ulyssecrn/usb-pd-card/jlcpcb/production_files/BOM-usb-pd-card.csv

Comment | Designator | Footprint | LCSC | Quantity
100k | R4 | R_0402_1005Metric | C25741 | 1
100nF | C5 | C_0402_1005Metric | C1525 | 1
10k | R6 | R_0402_1005Metric | C25744 | 1
10uF | C4 | C_0603_1608Metric | C19702 | 1
10uF | C2 | C_0603_1608Metric | C96446 | 1
15k | R5 | R_0402_1005Metric | C25756 | 1
1k | R10,R11,R12,R13,R14,R15,R16,R17,R18,R7,R8,R9 | R_0402_1005Metric | C11702 | 12
220nF | C1 | C_0402_1005Metric | C16772 | 1
47 | R1 | R_0402_1005Metric | C25118 | 1
5.1k | R2,R3 | R_0402_1005Metric | C25905 | 2
CH32X035G8U6 | U1 | WQFN-28-1EP_4x4mm_P0.4mm_EP2.7x2.7mm | C7437027 | 1
H7VL10B | D3,D4 | D_0402_1005Metric | C20615787 | 2
LED | D10,D11,D12,D13,D14,D15,D16,D2,D5,D6,D7,D8,D9 | LED_0603_1608Metric | C2286 | 13
ME6228A33M3G | U2 | SOT-23-3_L2.9-W1.6-P1.90-LS2.8-BR | C487914 | 1
NT3H2111W0FHKH | U3 | XQFN-8_L1.6-W1.6-P0.50-BL_NT3H2111W0FHKH | C710403 | 1
SMF20A | D1 | D_SOD-123F | C41411782 | 1
