ulyssecrn/usb-pd-card/usb-pd-card.kicad_pcb

## KiCad design usb-pd-card.kicad_pcb (2026-10-11)

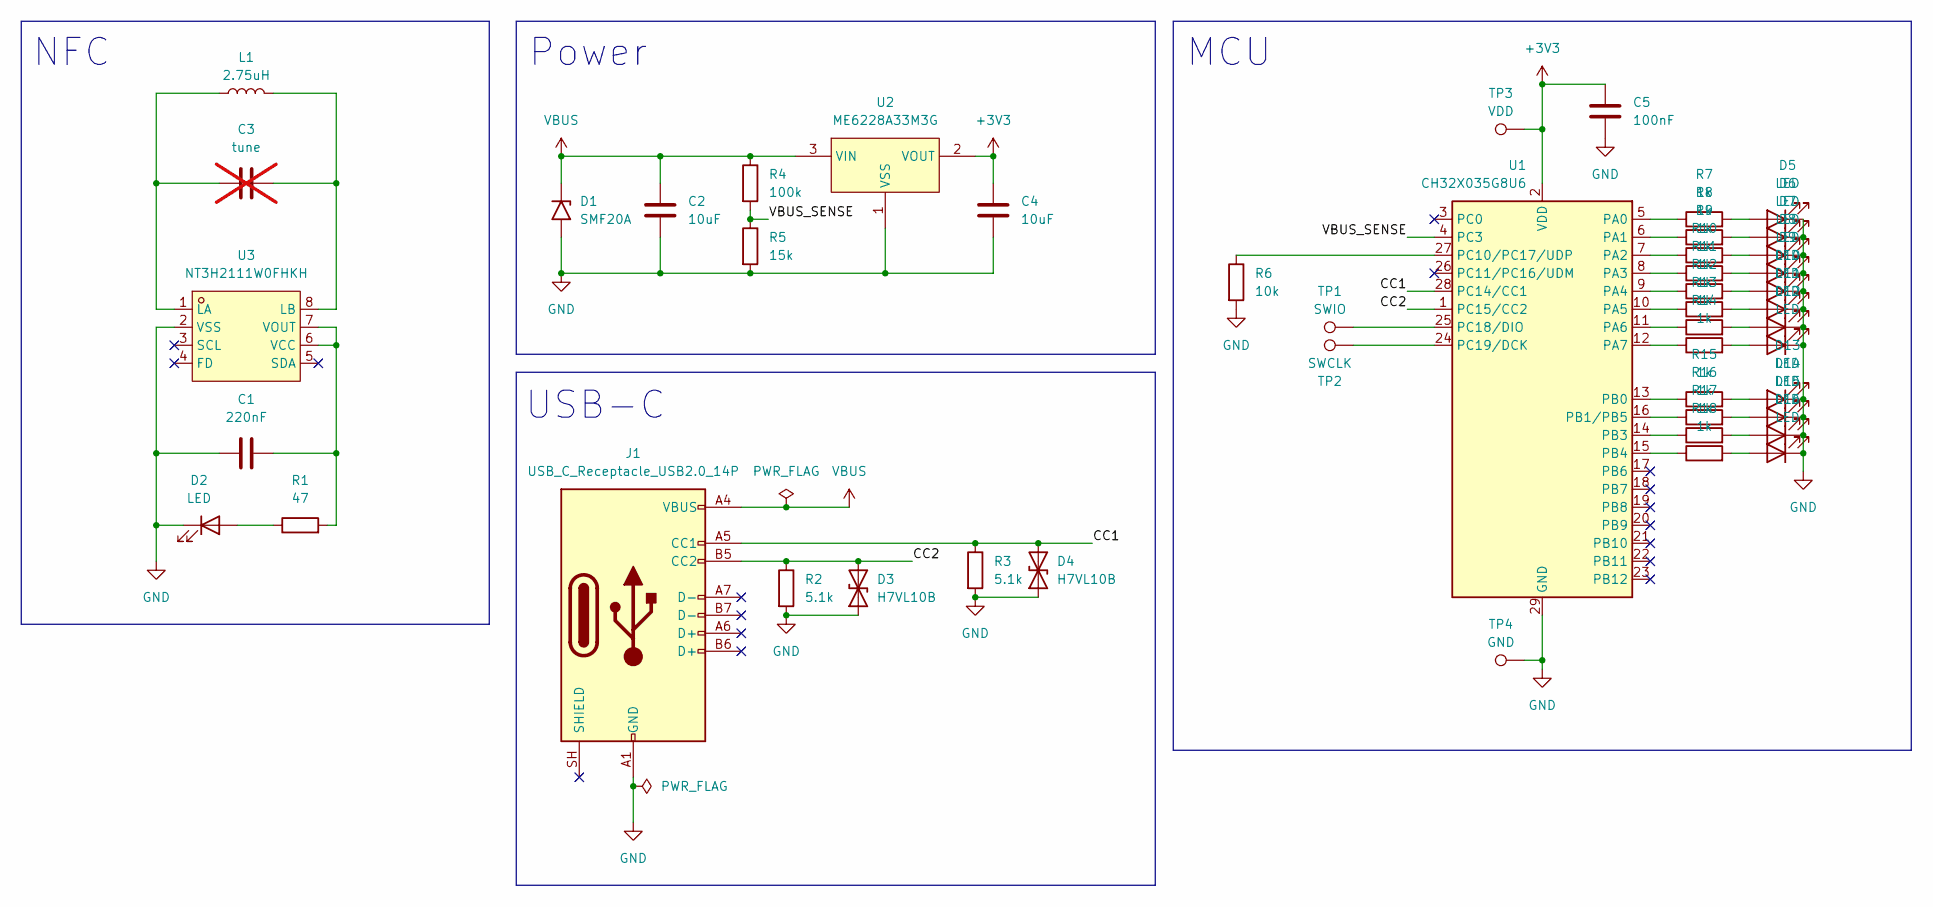
[picture p3: schematic usb-pd-card.kicad_sch]

Parts:
C1: 220nF; C_0402_1005Metric; LCSC C16772
C2: 10uF; C_0603_1608Metric; LCSC C96446
C3: tune; C_0402_1005Metric; not fitted
C4: 10uF; C_0603_1608Metric; LCSC C19702
C5: 100nF; C_0402_1005Metric; LCSC C1525
D1: SMF20A; D_SOD-123F; LCSC C41411782
D2, D5, D6, D7, D8, D9, D10, D11, D12, D13, D14, D15, D16: LED; LED_0603_1608Metric; LCSC C2286
D3, D4: H7VL10B; D_0402_1005Metric; LCSC C20615787
J1: USB_C_Receptacle_USB2.0_14P; USB_C_Paddle
L1: 2.75uH; NFC_Coil_Rect_38x46mm_R4_5T_W0.5_S0.3
R1: 47; R_0402_1005Metric; LCSC C25118
R2, R3: 5.1k; R_0402_1005Metric; LCSC C25905
R4: 100k; R_0402_1005Metric; LCSC C25741
R5: 15k; R_0402_1005Metric; LCSC C25756
R6: 10k; R_0402_1005Metric; LCSC C25744
R7, R8, R9, R10, R11, R12, R13, R14, R15, R16, R17, R18: 1k; R_0402_1005Metric; LCSC C11702
TP1: SWIO; TestPoint_Pad_1.0x1.0mm
TP2: SWCLK; TestPoint_Pad_1.0x1.0mm
TP3: VDD; TestPoint_Pad_1.0x1.0mm
TP4: GND; TestPoint_Pad_1.0x1.0mm
U1: CH32X035G8U6; WQFN-28-1EP_4x4mm_P0.4mm_EP2.7x2.7mm; LCSC C7437027
U2: ME6228A33M3G; SOT-23-3_L2.9-W1.6-P1.90-LS2.8-BR; MPN ME6228A33M3G; LCSC C487914
U3: NT3H2111W0FHKH; XQFN-8_L1.6-W1.6-P0.50-BL_NT3H2111W0FHKH; MPN NT3H2111W0FHKH; LCSC C710403

Connections:
+3V3: C4.1, C5.1, TP3.1 (1_1), U1.2 (VDD), U2.2 (VOUT)
/CC1: D4.2 (A2), J1.A5 (CC1), R3.1, U1.28 (PC14/CC1)
/CC2: D3.2 (A2), J1.B5 (CC2), R2.1, U1.1 (PC15/CC2)
/VBUS_SENSE: R4.2, R5.1, U1.4 (PC3)
GND: C1.1, C2.2, C4.2, C5.2, D1.2 (A2), D2.1 (K), D3.1 (A1), D4.1 (A1), D5.1 (K), D6.1 (K), D7.1 (K), D8.1 (K), D9.1 (K), D10.1 (K), D11.1 (K), D12.1 (K), D13.1 (K), D14.1 (K), D15.1 (K), D16.1 (K), J1.A1 (GND), J1.A12 (GND), J1.B1 (GND), J1.B12 (GND), R2.2, R3.2, R5.2, R6.2, TP4.1 (1_1), U1.29 (GND), U2.1 (VSS), U3.2 (VSS)
unnamed: D2.2 (A), R1.1
unnamed: D5.2 (A), R7.2
unnamed: D6.2 (A), R8.2
unnamed: D7.2 (A), R9.2
unnamed: D8.2 (A), R10.2
unnamed: D9.2 (A), R11.2
unnamed: D10.2 (A), R12.2
unnamed: D11.2 (A), R13.2
unnamed: D12.2 (A), R14.2
unnamed: D13.2 (A), R15.2
unnamed: D14.2 (A), R16.2
unnamed: D15.2 (A), R17.2
unnamed: D16.2 (A), R18.2
unnamed: R7.1, U1.5 (PA0)
unnamed: R8.1, U1.6 (PA1)
unnamed: R9.1, U1.7 (PA2)
unnamed: R10.1, U1.8 (PA3)
unnamed: R11.1, U1.9 (PA4)
unnamed: R12.1, U1.10 (PA5)
unnamed: R13.1, U1.11 (PA6)
unnamed: R14.1, U1.12 (PA7)
unnamed: R15.1, U1.13 (PB0)
unnamed: R16.1, U1.16 (PB1/PB5)
unnamed: R17.1, U1.14 (PB3)
unnamed: R18.1, U1.15 (PB4)
unnamed: R6.1, U1.27 (PC10/PC17/UDP)
unnamed: TP1.1 (1_1), U1.25 (PC18/DIO)
unnamed: TP2.1 (1_1), U1.24 (PC19/DCK)
unnamed: C3.1, L1.1, U3.1 (LA)
unnamed: C3.2, L1.2, U3.8 (LB)
unnamed: C1.2, R1.2, U3.6 (VCC), U3.7 (VOUT)
VBUS: C2.1, D1.1 (A1), J1.A4 (VBUS), J1.A9 (VBUS), J1.B4 (VBUS), J1.B9 (VBUS), R4.1, U2.3 (VIN)

Notes on the sheet:
MCU
USB-C
Power
NFC

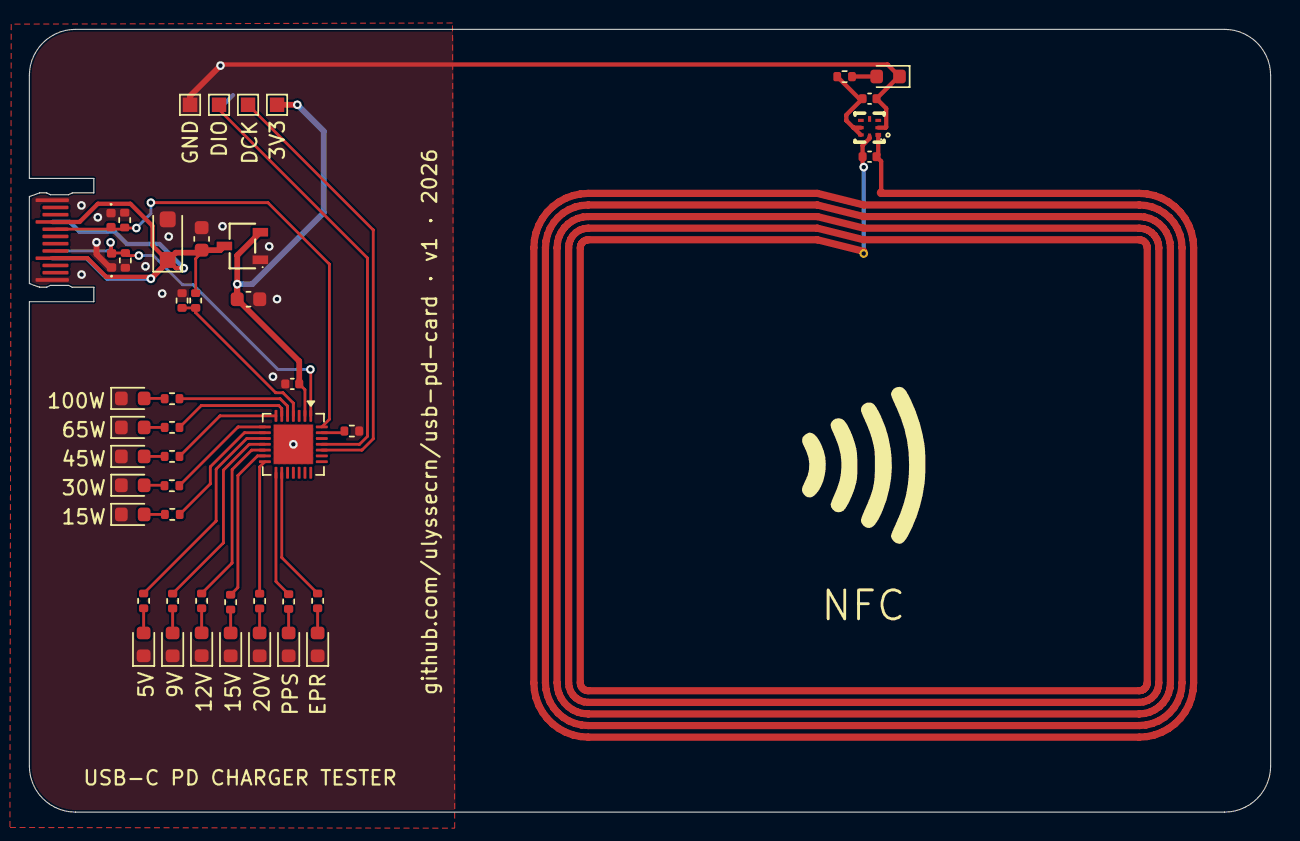
[picture p4: board usb-pd-card.kicad_pcb from above]

Board: 2 copper layers, 85.6 x 54.0 mm, 48 parts (0 on the bottom side), 37 nets.
