ulyssecrn/usb-pd-card/(commit log)

2026-10-07 schematic done
    [usb-pd-card.kicad_pcb, usb-pd-card.kicad_sch]
2026-10-11 v1: PCB layout complete, JLC production files
    - Credit-card outline (85.6 x 53.98 mm, r3.18), USB-C paddle on the left edge
    - Electronics routed, GND pour on both layers over the electronics half
    - NFC coil 46 x 38 mm, 5 turns (est. 2.31 uH, f0 ~14.4 MHz), C3 DNP
    - Regulator ME6228A33M3G (SOT-23-3), C2 0603, D1 SOD-123F footprint
    - Contact info + QR code on the back, LED/test-pad labels on the front
    - tools/nfc_coil.py coil generator and lib/nfc-coils.pretty footprint
    - JLCPCB Gerbers, BOM and CPL in jlcpcb/
    - README with board renders; AGENTS.md updated with final decisions
    [BOM-usb-pd-card.csv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]
2026-10-11 Widen USB-C paddle slots to 1.0 mm (JLC minimum milled width)
    Slots grow outward by 0.08 mm (now out to +/-4.25 mm); tongue unchanged.
    Gerbers re-exported; BOM and CPL unchanged.
    [usb-pd-card-CuBottom.gbr, usb-pd-card-CuTop.gbr, usb-pd-card-EdgeCuts.gbr, usb-pd-card-MaskBottom.gbr, usb-pd-card-MaskTop.gbr, usb-pd-card-NPTH.drl, usb-pd-card-PTH.drl, usb-pd-card-PasteBottom.gbr]
2026-10-11 Silkscreen text to JLC minimum (1.0 mm height, 0.15 mm stroke); re-export Gerbers
    [usb-pd-card-CuBottom.gbr, usb-pd-card-CuTop.gbr, usb-pd-card-EdgeCuts.gbr, usb-pd-card-MaskBottom.gbr, usb-pd-card-MaskTop.gbr, usb-pd-card-NPTH.drl, usb-pd-card-PTH.drl, usb-pd-card-PasteBottom.gbr]
2026-10-21 Firmware: PD sink + LED display, working on hardware
    - firmware/: CH32X035 firmware on ch32fun (submodule: mtabini/ch32fun fork with
    the RP2040 programmer). Reads the charger's Source_Capabilities, lights the
    voltage/PPS/EPR LEDs and the wattage bar, and only requests 5 V. Falls back to
    a blinking 5V (plus 15W for 3 A Rp) on non-PD sources.
    - usbpd.h: project copy of ch32fun's usbpd_sink library with fixes found on the
    first card: CC2 attach (20 us comparator settle), swapped UFP/DFP enum,
    CC_LVE transmit level, 1 ms gap before the Request, and replies to
    post-contract messages.
    - LOG=1 PD message trace and CCDIAG=1 CC comparator view for debugging.
    - Flashing via YD-RP2040 (make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
    [pdcard.c, usbpd.h]
2026-10-21 README: real photos and plug-in GIF, v1 status
    - Replace the KiCad renders with a photo of the v1 cards and a GIF of plugging
    in a charger (LED self-test slowed 5x, then the charger's offer).
    - Status: v1 works; PD tested on 10 sources, NFC needs a one-time format.
    - Mention the non-PD fallback (blinking 5V) and the firmware/ folder.
    - AGENTS.md: gold-finger paddle is a maybe for v2, not a decision.
